horizon-527/pawtrack/README.md

# PawTrack

宠物独立联网定位器 + 微信小程序。目标：项圈设备获取 GNSS 位置，通过 4G 回传，主人在微信中查看位置和运动轨迹。

**当前状态：软件与可编译硬件原型已建立；尚未完成实体板定位、真实微信登录、公网部署及佩戴验收。**

新增 [定制硬件 EVT-A1 交厂包](hardware/custom/evt-a1/README.md)：可编辑原理图、四层布线 PCB、BOM、Gerber/钻孔/贴片坐标、外壳 STL、Air780EGH 应用和36项实体验收表。ERC/DRC/原理图与 PCB 一致性检查通过；制造发布状态 **HOLD**，先由方案商关闭引脚资料矛盾、电源和叠层评审，再做两台样机。该方案由厂商代采、贴片、装配，详见 [交厂说明](hardware/custom/evt-a1/factory-handoff.md)。

## 已实现
- 微信小程序地图、实时刷新、按日期查询轨迹、坐标转换、轨迹缺口分段。
- 微信登录接口、设备绑定、用户设备隔离、在线/定位过期状态、寻找模式请求与设备确认。
- FastAPI + SQLite 服务，独立设备密钥、一次性绑定码、会话过期/撤销、限流、数据删除与30天保留。
- ESP-IDF v5.4.2 固件：SIM7670G AT通信、GNSS读取、HTTPS上传、NVS缓存、模式心跳；ESP32-S3构建通过。
- 设备模拟器、GNSS日志回放、设备初始化、备份恢复工具、Docker/Caddy配置、CI。

## 先体验小程序
微信开发者工具导入 `miniprogram/`。默认使用游客 AppID 和模拟路线，明确标记演示数据。演示无需真实硬件、服务器或微信登录。
正式接入必须替换 AppID 和 HTTPS 服务地址；项目未使用其他项目的 AppID 或密钥。

## 本地运行与验证
```sh
python3 -m venv work/venv
work/venv/bin/pip install -r requirements.lock.txt
work/venv/bin/python tools/check.py
work/venv/bin/uvicorn server.production:create_app --factory --host 127.0.0.1 --port 8788 --no-access-log
```
不配置真实微信密钥时，登录返回“尚未配置”，不会伪造用户身份。接口测试使用隔离的微信响应替身，不代表真实微信认证通过。

## 文档入口
- **[从采购到真实定位：逐步操作指南](docs/getting-started.md)**
- [完整采购和组装](hardware/procurement-and-assembly.md)
- [真机实测与验收表](docs/acceptance.md)
- [常见问题排查](docs/troubleshooting.md)
- [实施与验收计划](docs/plan.md)
- [硬件采购路线](hardware/README.md)
- [固件配置与烧录](firmware/espidf/README.md)
- [服务部署和备份](deploy/README.md)
- [API v1](docs/api-v1.md)
- [测试记录与待办](docs/verification.md)
- [上线门槛](docs/release.md)
- [开源许可](THIRD_PARTY.md)

## 最新完善
支持继续添加另一只宠物，位置5秒轮询/轨迹30秒缓存刷新、手动刷新、历史轨迹终点、会话过期处理；已在微信开发者工具运行并修复坐标库兼容和地图标记渲染问题。
提供独立真机项目配置工具、部署健康/TLS检查、每日自动备份与7天清理、离线恢复、私有TLS负例测试服务。正式微信登录、实体GNSS/4G与佩戴仍须按验收表测试。

## 原始本地原型
`python3 server/app.py`（8787）与 `python3 tools/simulate.py` 为早期本机开发原型；仅监听本机，固定开发令牌，不可公网部署。它的数据库与 v1 独立。
小程序 `config.js` 可切换 apiMode=prototype 且 apiBase 改为8787进行旧版联调；正式流程保持v1。

## 完成产品仍需的外部条件
实体开发板与SIM；小程序AppID/Secret；可部署的服务器/域名；实际定位、TLS证书验证、功耗及佩戴测试。开发板用于桌面验证，不能直接作为宠物项圈成品。
