horizon-527/pawtrack/hardware/README.md

# 硬件路线
当前委托路线改为 [Air780EGH 定制工程样机、由国内厂商代采装配](custom/evt-a1/factory-handoff.md)。CAD、制造输出、外壳和样机验收资料见 [EVT-A1](custom/evt-a1/README.md)。该版尚未投板、实测或获准佩戴。下述微雪开发板内容保留为旧桌面验证路线，不再作为本次采购要求。

[国内采购、到货检查、组装、CA与电池/外壳说明](procurement-and-assembly.md)
推荐桌面原型候选：Waveshare ESP32-S3-SIM7670G-4G，官方介绍包含 GNSS 与 LTE Cat-1。
资料：https://docs.waveshare.net/ESP32-S3-SIM7670G-4G/
国内采购：微雪中文资料所指向的天猫旗舰店 https://weixuesm.tmall.com/ ，或国内商城 https://www.waveshare.net/ 。搜完整型号，套装与版本下单前核对。

这是一块用于开发和验证的板子，不是已可佩戴的成品项圈。购买前必须按当前版本确认：模块频段与国内运营商适配、GNSS 是否实际装配、天线是否包含、供电要求、板尺寸及电池接口。资料充分不代表已实测适配。

采购顺序：
1. 一块上述完整开发板、配套 GNSS 和 4G 天线、匹配的数据 USB 线。
2. 先用厂商支持的稳定 USB 供电，购买一张支持该模块联网的数据 SIM；确认 APN 和套餐是否允许物联网设备。
3. 完成联网和定位后，再依照实际供电接口选带保护电池与充电组件，避免买错极性和规格。
4. 项圈外壳与自制 PCB 留到功耗测试后。

桌面测试记录：日期、板版本、运营商、地点、首次定位耗时、定位点有效比例、上报间隔、延迟、供电和发热。
不要直接把裸板、电池和天线绑到宠物脖子上。最终需要封装、电池保护和牢固固定；猫用方案还需评估脱扣项圈。

## 首轮采购决定
一块官方完整 ESP32-S3-SIM7670G-4G 开发板（优先按V2文档匹配当前在售版本），配套4G/GNSS天线和数据USB线，一张经卖家/运营商确认可用于此模块的数据SIM。总预算暂按1500元上限规划；实际订单价格尚未核验，尚未下单。
先使用稳定USB供电。首轮不买电池、自制PCB或项圈外壳，待真实电流和板尺寸验证后由测量决定。
