horizon-527/pawtrack/docs/acceptance.md

# 真机实测与验收

目的：证明真实设备脱离电脑和手机网络，仍能将真实卫星位置上传，并在自己的微信小程序显示位置/轨迹。自动测试、模拟路线和固件编译不能代替此验收。所有表格初始状态是“待测”。

## 准备和记录

使用自己的 AppID/服务器和专用测试设备，装好天线与 SIM，用稳定 USB 供电。固件实际配置要与服务器同一套设备身份；小程序关闭演示。记录：测试日期、代码提交、PCB 版本、模组固件版本、SIM 运营商/APN、供电方式、测试地点类别、手机/微信版本、执行人。

不在公开仓库上传原始坐标或密钥。私人记录需包括：服务器 receivedAt 与设备 capturedAt、上传间隔、当前模式、在线/定位状态、断网起止、重启次数、缓存点数、电压/电流/Wh。电流与佩戴适配以实体测量为准。

以下数值是**首轮通过标准**，不是已实测指标。每项填写通过/失败、实际数值和证据。失败先排查再重测，不能用“编译成功”代签。

## A. 微信与服务器

| 编号 | 实际操作 | 通过标准 | 结果 |
|---|---|---|---|
| A01 | 从电脑和手机网络检查 HTTPS /health | 证书无异常，健康返回 ok；doctor 检查成功 | 待测 |
| A02 | 真 AppID 手机登录 | 关闭演示后真实登录；未配置凭证不产生身份 | 待测 |
| A03 | 用新 bindingCode 绑定 pet-001 | 名称出现在设备列表；同一码再绑定失败 | 待测 |
| A04 | 等待绑定码 24h 或测试库设置过期 | 过期码拒绝；重发后新 token/绑定码有效 | 待测 |
| A05 | 绑定 pet-002，再切换两只宠物 | 名字、标记、轨迹分别正确，无前一只残留 | 待测 |
| A06 | 第二个微信账号访问 pet-001 | 不出现在列表；接口无法读取或改模式 | 待测 |
| A07 | 退出登录再登录；撤销测试会话 | 旧会话失效，重新登录能访问自己的设备 | 待测 |
| A08 | 测试服务器重启容器/主机 | 设备绑定与轨迹仍在，服务和每日备份恢复 | 待测 |
| A09 | 按运维手册备份并在隔离实例恢复 | 数据库完整，绑定/轨迹一致，不串号 | 待测 |
| A10 | 用专用测试账号执行删除账户 | 在线库轨迹删除、会话与原设备密钥失效；备份到期清理 | 待测 |

删除使用一次性的测试账号/设备；主账号保留。测试完成后恢复正式设备身份材料，不把模拟器和真实板共用同一编号长期运行。

## B. 定位、地图与模式

| 编号 | 实际操作 | 首轮通过标准 | 结果 |
|---|---|---|---|
| B01 | 室外开阔地冷启动，记录首点 | 5 分钟内出现有效坐标/真实 UTC；否则记失败并排查 | 待测 |
| B02 | 静止开阔地 10 分钟，与已知地标对照 | 无数百米系统性坐标偏移；95% 点距参考点 ≤30m 作为初始目标 | 待测 |
| B03 | 人持设备走 300～500m | 路线顺序正确，终点和转弯合理，无人为补点 | 待测 |
| B04 | 普通模式观察 10 分钟 | 采集周期目标 60s；新点端到端年龄95分位 ≤90s | 待测 |
| B05 | 请求寻找模式并持续 10 分钟 | 120s 内显示设备确认；目标周期10s，新点年龄95分位 ≤30s | 待测 |
| B06 | 恢复普通模式 | 设备确认普通，回到目标60s；不只改变页面文字 | 待测 |
| B07 | 比较“后台已经存下”和“小程序显示” | 前台位置约5s轮询；轨迹约30s自动更新，手动刷新即时查询 | 待测 |
| B08 | 查有记录日期、空日期、北京时间跨日 | 点归属日期正确；空日期显示0点；历史终点标记与当天最新位置区分 | 待测 |
| B09 | 模拟至少10分钟断点后再行走 | 不把长时间缺失连接成连续直线 | 待测 |
| B10 | 保持在线，把 GNSS 天线带入无信号环境 | 显示暂无卫星定位，旧点超过120s提示过期；不生成假坐标 | 待测 |
| B11 | 设备关机超过180s | 页面显示离线，旧位置仍标为过期；不能继续声称实时 | 待测 |
| B12 | 快速切宠物、日期、演示，再隐藏/返回小程序 | 旧异步结果不盖住新选择，页面隐藏后停止刷新 | 待测 |
| B13 | 未接/未校准电量计 | 电量显示暂不可用；不显示模拟器的85%为真实电量 | 待测 |

年龄统计只计算首次观察到的不同新点，`观察时刻-capturedAt`；旧点反复刷新不能当作多次新样本。至少记录20个普通点、60个寻找点，再计算排序后95分位。实际延迟超过目标时，检查 AT HTTPS 阻塞与信号；需要时调整通信实现，不能用更快的页面轮询掩盖设备未上传。

## C. 网络、缓存与重启

| 编号 | 实际操作 | 通过标准 | 结果 |
|---|---|---|---|
| C01 | 断开电脑，关闭手机热点，设备用 USB 移动电源运行 | 仍通过 SIM 上传；手机距离改变不影响设备通信 | 待测 |
| C02 | 保持 GNSS/电源，暂时阻断测试服务或置于无蜂窝覆盖环境 | 上传失败后点保留，不能得到成功 ACK 就出队 | 待测 |
| C03 | 缓存未满时断网5分钟，再恢复 | 旧点补传，无重复记录，当前状态最终恢复 | 待测 |
| C04 | 离线缓存形成后重启 ESP，再恢复网络 | 已持久化队列仍可补传；新bootId不与旧序号冲突 | 待测 |
| C05 | 在隔离环境让设备积压超过64点 | 满后保留原64点，拒绝新点并提示；不宣称全部离线点都保存 | 待测 |
| C06 | 在测试服务制造重复ACK/丢失ACK | 重发去重；仅同bootId/sequence的确认能出队 | 待测 |
| C07 | 模组单独掉电再恢复，ESP保持供电 | 重新配置GNSS/TLS并恢复上传；不需要持续人为重启 | 待测 |
| C08 | 无首次GNSS时间冷启动，随后移到室外 | 不绕过证书时间检查；获得时间后正常联网 | 待测 |
| C09 | 换成无效设备token/撤销测试设备密钥 | 服务拒绝；设备保留未确认点，不偷偷降级为HTTP | 待测 |

当前固件64点缓存：理想60s采样约64分钟、10s采样约10分40秒；网络阻塞会影响实际采样。队列满后的新位置不能保留，这是已知限制。首轮先把正常网络和短时断网验收做完。

## D. 模组 TLS 的四组实测

这是硬件上线门槛，使用独立测试 CA 和自己控制的测试域名。**不向外部证书测试网站发送真实 deviceToken，也不关闭证书检查。** 项目提供可重复生成的本地 TLS 测试服务；电脑端正例、错误根、过期和错误域名已经自动测试，但模组端仍待实测。

1. 另准备一个测试域名，例如 `tls.你的域名`，DNS 指向可临时开放8443的测试机。生成证书，目录必须是新目录：

```sh
python3 tools/tls_lab.py generate --directory secrets/tls-lab --hostname tls.你的域名
python3 tools/tls_lab.py serve --directory secrets/tls-lab --mode valid --host 0.0.0.0 --port 8443
```

2. ESP 固件停止，模组用 AT 口操作，GNSS获取正确时间后设置模组 UTC 时钟。用 CA 导入工具把 `secrets/tls-lab/ca.pem` 装为 `pawtrack-lab.pem`。不要覆盖生产 CA。
3. 按手册设置：TLS1.2、authmode=1、ignorelocaltime=0、enableSNI=1、cacert=pawtrack-lab.pem；HTTPINIT，HTTPPARA的SSLCFG=0、URL=`https://tls.你的域名:8443/health`，HTTPACTION=0（GET）。不设置 Authorization。
   对应AT指令如下；域名须替换，模组时间须从实际GNSS UTC设置好：

```text
AT+CSSLCFG="sslversion",0,3
AT+CSSLCFG="authmode",0,1
AT+CSSLCFG="ignorelocaltime",0,0
AT+CSSLCFG="enableSNI",0,1
AT+CSSLCFG="cacert",0,"pawtrack-lab.pem"
AT+HTTPINIT
AT+HTTPPARA="SSLCFG",0
AT+HTTPPARA="URL","https://tls.你的域名:8443/health"
AT+HTTPACTION=0
AT+HTTPTERM
```

4. 完成表中四组。每次切服务先 Ctrl+C 停止，再用相同命令更改 `--mode`；域名、端口、时间和网络保持相同。

| 组别 | 服务证书/模组信任根 | 期望 |
|---|---|---|
| T01 正例 | --mode valid，信任ca.pem | 请求成功，HTTP 200 |
| T02 错误根 | --mode valid，把untrusted-ca.pem导入独立文件并选择它 | TLS失败，不能出现有效HTTP 200 |
| T03 过期 | --mode expired，重新选择正确ca.pem | TLS失败；此时主机名和CA正确 |
| T04 错误域名 | --mode wrong-host，信任正确ca.pem，URL仍是原测试域名 | TLS失败；证书有效但SAN只覆盖wrong.原域名 |

记录模块版本、设置、返回码，不记录真实设备密钥。T04如果竟然成功，说明该模组/配置没有满足本项目主机名验证要求：该硬件不得投入真实使用，通信实现需要迁移到经过验收的 PPP + ESP-TLS。完成后恢复生产 CA 配置与正式固件，关闭测试端口，测试私钥不发布。

## E. 功耗、外壳与佩戴

| 编号 | 实际操作 | 通过标准 | 结果 |
|---|---|---|---|
| E01 | 普通/寻找/弱信号各运行并测峰值 | 不因压降持续重启，电源符合厂家规格 | 待测 |
| E02 | 普通和寻找各记录24h电量Wh | 实测结果能支持所选电池/充电方式；无虚构续航 | 待测 |
| E03 | 先测试电池保护/极性/充电，再取下USB | 供电稳定，正确充电保护；发热异常立即停测 | 待测 |
| E04 | 非金属封装后重复B01/B03/C01 | 外壳不遮挡GNSS/LTE，不造成明显退化 | 待测 |
| E05 | 空壳/等重模型固定与拉扯 | 固定可靠、边缘圆滑、无线材勒颈/勾挂风险 | 待测 |
| E06 | 合适项圈/胸背上由人监督短时佩戴 | 重量尺寸适配，无磨擦、啃咬、过热或不适 | 待测 |
| E07 | 按目标防水方案由供应商验证 | 有真实防水报告才标等级；不能拿裸板淋水验收 | 待测 |

当前未实现精准电量显示、休眠续航优化、可认证防水、量产 PCB 和已适配宠物的外壳。由实体数据决定这些参数；正式可佩戴产品必须完成 E 项，不把桌面软件通过视为可佩戴完成。

## 一次测试的记录模板

```
代码提交 / 日期 / 执行人：
设备PCB / 模组固件 / SIM运营商 / APN：
手机 / 微信版本 / 小程序版本：
用例编号：
操作及环境：
预期：
实际数值：
通过或失败：
私人证据位置（脱敏截图/本地日志/功耗记录）：
修复与重测结果：
```

首次可用门槛：A01～A03、A06、B01～B07、B10～B11、C01～C04和T01～T04通过，才进入持续人持试运行。正式发布还必须通过其余权限/运维用例、[发布门槛](release.md)和相应E项。
