horizon-527/pawtrack/hardware/custom/evt-a1/previews/enclosure-dimensions.png

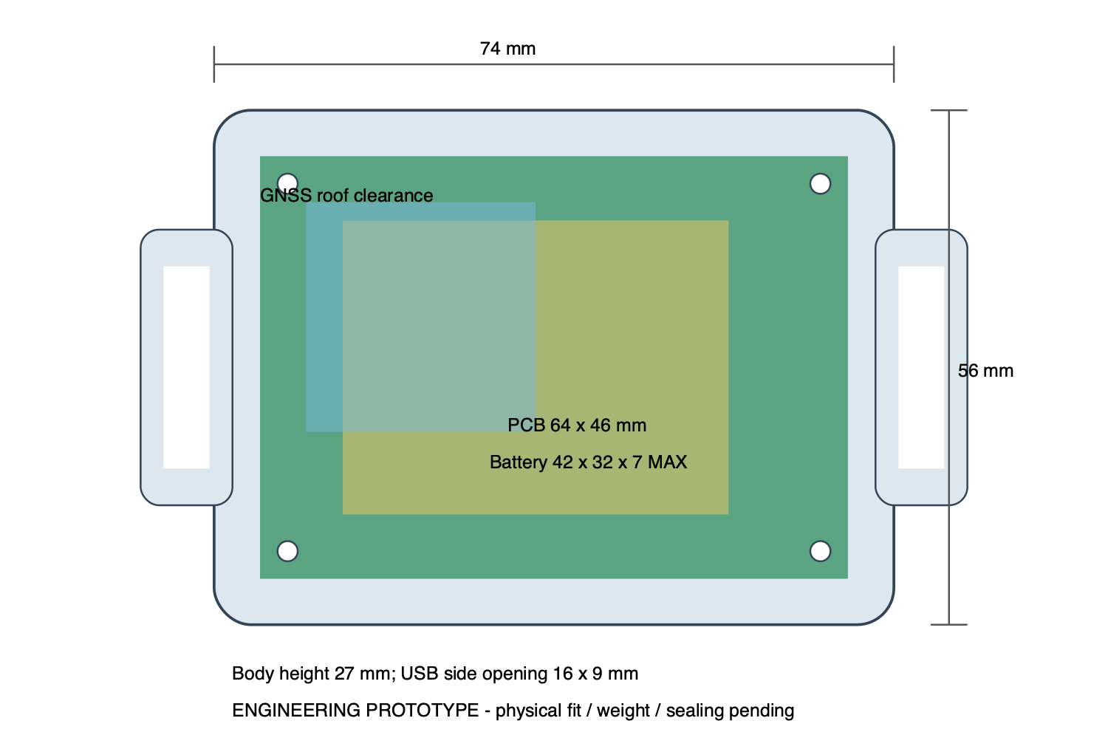
hardware/custom/evt-a1/previews/enclosure-dimensions.png
