horizon-527/pawtrack/hardware/custom/evt-a1/previews/pawtrack.png

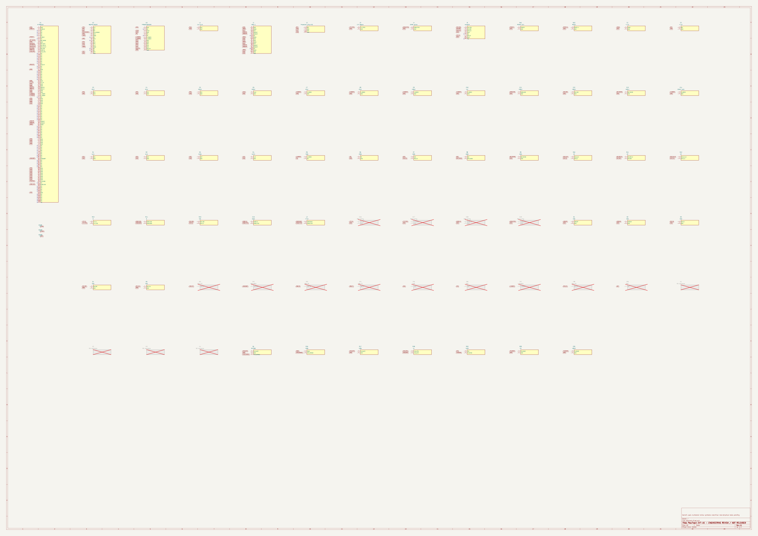
hardware/custom/evt-a1/previews/pawtrack.png
