horizon-527/pawtrack/hardware/custom/evt-a1/previews/pcb-bottom.png

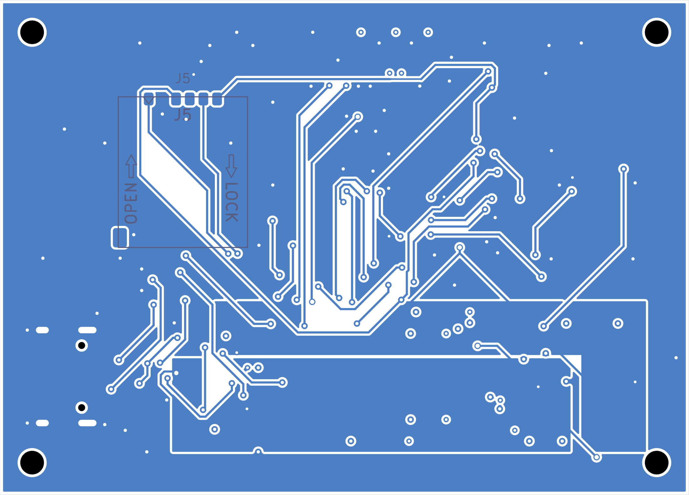
hardware/custom/evt-a1/previews/pcb-bottom.png
