horizon-527/pawtrack/hardware/custom/evt-a1/previews/pcb-top.png

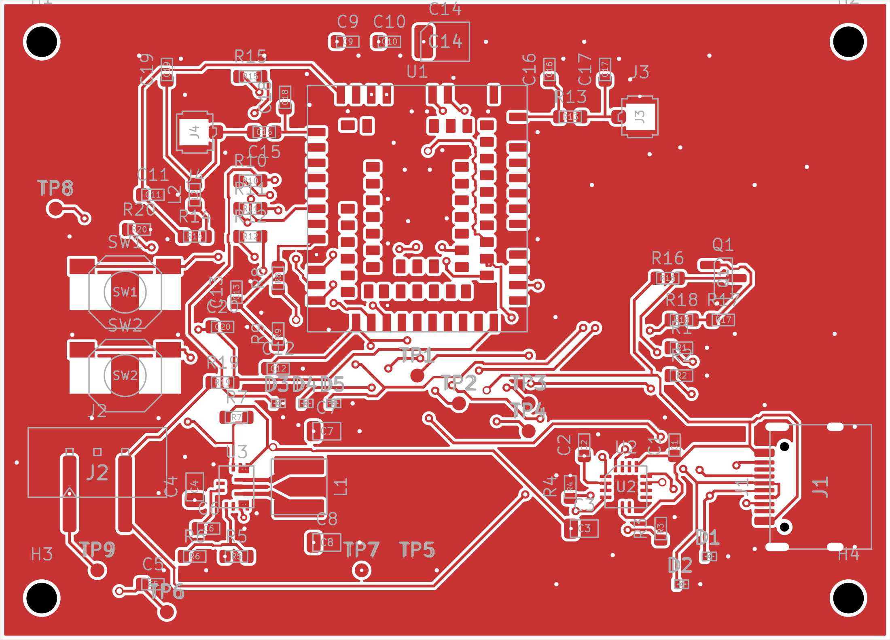
hardware/custom/evt-a1/previews/pcb-top.png
