horizon-527/pawtrack/miniprogram/assets/pet-marker.png

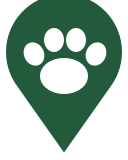
miniprogram/assets/pet-marker.png
