horizon-527/pawtrack/hardware/custom/evt-a1/acceptance.csv

ID | 类别 | 操作 | 验收依据/工程目标 | 状态 | 实际值/证据 | 仪器/环境 | 测试人/日期
REV-01 | 资料 | 合宙确认实际模组 PIN2 与 PIN103 | 最新参考图和硬件手册矛盾得到书面关闭；记录模组批次和依据 | NOT_RUN
REV-02 | 资料 | 方案商独立审核电路/BOM/封装 | 确认109脚方向、RNM15脚、U.FL信号脚、USB/SIM/QFN/NMOS；记录签署版本 | NOT_RUN
FAB-01 | 制板 | 核验叠层、阻抗条、塞孔盖帽和钢网 | 厚1.0mm目标；RF按实际叠层50Ω±10%；VIPPO无开放吸锡孔；提交实际报告 | NOT_RUN
ASM-01 | 贴片 | AOI/X-ray和断电阻值检查 | 无反向、桥连、漏贴；U1/QFN焊接检查；电源无短路；DNP不误贴 | NOT_RUN
PWR-01 | 电源 | 禁用REG_EN后以限流台架电源验证USB/SYS | 不接裸电池；CE默认高禁充；SYS满足BQ规格；没有异常发热 | NOT_RUN
PWR-02 | 电源 | BAT模拟3.3/3.8/4.2V并测MODEM电压 | 目标3.8V；整个测试不超模组3.3–4.3V范围；保存负载及波形 | NOT_RUN
PWR-03 | 电源 | 电子负载模拟0.05A→2A→0.05A阶跃 | 至少100轮、弱网发射同时观察；MODEM不低于3.3V、不复位；记录脉宽和示波器带宽 | NOT_RUN
PWR-04 | 电源 | 4G突发时拔插USB、切换电池供电 | 不复位、不丢已确认队列身份；USB输入受限；电池承担峰值 | NOT_RUN
BAT-01 | 电池 | 核对电池型号、线束和保护资料 | 尺寸≤42×32×7mm、3A放电、独立保护和真实容量；三线极性逐台确认 | NOT_RUN
BAT-02 | 电池 | 用专用测试夹具验证保护阈值 | 按供应商阈值停止过充/过放/过流；提供仪器记录；禁止真实电池硬短路 | NOT_RUN
CHG-01 | 充电 | 未烧程序/复位/未合格配置时接USB | GPIO27 NMOS关，CE高，充电禁止；不是只看指示灯 | NOT_RUN
CHG-02 | 充电 | 合格配置及25°C传感器条件下充电 | 充电电流符合约350mA设计及电池限制；终止电压符合4.2V芯片/电池公差，不超电池规格 | NOT_RUN
CHG-03 | 充电 | 以NTC模拟器+温箱校准0/5/25/40/45°C | NTC真实曲线与ADC温度关键温区误差≤2°C；≤0及≥45°C不充；合格开启范围只能更保守 | NOT_RUN
CHG-04 | 充电 | NTC断路/短路、ADC无效、固件停止/重启 | 禁止充电；核对硬件TS独立切断点；不能由软件假定后备保护通过 | NOT_RUN
CHG-05 | 充电 | 整机充电及正常/弱网/寻找负载热测试 | 记录电芯、IC、外壳最高温和环境；不超器件/电池及经评审接触温度限制 | NOT_RUN
RF-01 | 天线 | 核对GNSS_VDD电压/电流与有源天线规格 | 实测符合天线范围，PIN98不承担其他负载；记录天线型号和安装方向 | NOT_RUN
RF-02 | 天线 | LTE天线装壳前后VNA/OTA及注册测试 | 提供实际频段、安装/人体靠近条件和曲线；按天线/模组厂家指标评估，不把能上网当匹配合格 | NOT_RUN
GNSS-01 | 定位 | 开阔室外冷启动三次并记录时间 | 首轮验收目标每次≤180s获得真实定位；UTC/WGS84字段完整，目标不是实测承诺 | NOT_RUN
GNSS-02 | 定位 | 已知参考点静止10分钟、空旷路段行走 | 首轮目标95%点距参考≤20m；记录原始点、卫星条件和算法；异常点分析 | NOT_RUN
GNSS-03 | 定位 | 室内/遮挡/拔天线后观察状态 | 无有效新点时不伪造坐标；心跳fixValid=false；小程序旧点过期提示正确 | NOT_RUN
NET-01 | 联网 | 激活SIM、APN及运营商频段验证 | 独立4G注册/请求成功；卡号/密钥仅私下保存；记录套餐限制 | NOT_RUN
TLS-01 | 安全 | 实机访问正确CA/有效证书/正确主机名 | 成功；记录exact底层固件版本、证书链和应用哈希 | NOT_RUN
TLS-02 | 安全 | 用错误CA连接测试网关 | 连接拒绝；不上传令牌/位置；不做无CA回退 | NOT_RUN
TLS-03 | 安全 | 有效时间下访问过期证书网关 | 连接拒绝；记录RTC和证书有效期，不以网络超时代替认证拒绝 | NOT_RUN
TLS-04 | 安全 | 正确CA但错误域名证书网关 | 主机名认证拒绝；此测试通过才允许tls_qualified=true | NOT_RUN
APP-01 | 联调 | 真实微信登录、逐台绑定、查看最新点和轨迹 | 与实体设备编号一致；未经归属的用户读不到设备；真实身份联调完成 | NOT_RUN
APP-02 | 联调 | 小程序切finding再normal，跟踪设备心跳 | pending到实际ACK；寻找采样目标10s、普通60s；测采集到展示延迟，工程目标分别≤30s/90s | NOT_RUN
APP-03 | 联调 | 断网10分钟后恢复，检查队列及轨迹 | 已采点按bootId/sequence补传、去重；满64点有丢新计数；不宣称无限缓存 | NOT_RUN
APP-04 | 联调 | 重启设备/中断队列写入/重发延迟ACK | 启动编号不复用；不把错误ACK当成功；记录队列恢复及fskv掉电表现 | NOT_RUN
APP-05 | 联调 | 断电超过180s；跨北京时间自然日查轨迹 | 离线/过期状态及历史日切换正确；WGS84只在地图展示边界转GCJ02 | NOT_RUN
APP-06 | 联调 | 撤销设备密钥/删除账户后尝试上传 | 拒绝旧令牌；设备保留失败队列，使用者看不到已解除数据 | NOT_RUN
LIFE-01 | 续航 | 正常/寻找/弱网分别连续24h采电池侧Wh | 记录平均/峰值、掉线、温度、SIM流量；按实际容量和截止条件计算续航，不使用USB侧直接冒充 | NOT_RUN
MECH-01 | 外壳 | 装配两台，核对电池/SIM/天线/USB/螺丝净空 | 电池不压不刺、不被螺丝顶到；陶瓷不挤；接口可插拔；NTC紧贴电芯 | NOT_RUN
MECH-02 | 外壳 | 称重、等重空壳及人持运动、固定件拉力测试 | 记录实重、尺寸、测试载荷/次数；固定无松脱、锐边、磨损；佩戴对象需单独评估 | NOT_RUN
MECH-03 | 外壳 | 明确防水目标并由方案商修订密封结构测试 | 本版开口无IP声明；有防水需求必须改密封/充电口方案并重新验证 | NOT_RUN
DEL-01 | 交付 | 对照全部文件及测试记录逐台验收 | 每项有实际值/仪器/照片及通过结论；提供最终版本，失败项不得标已完成 | NOT_RUN
