horizon-527/pawtrack/hardware/custom/evt-a1/enclosure/lid-assembly.stl

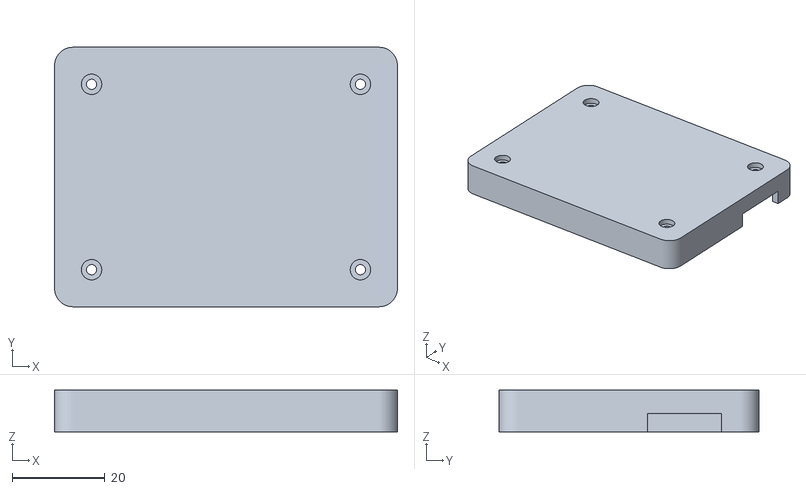
[picture p7: CAD file, 2026-10-11]
hardware/custom/evt-a1/enclosure/lid-assembly.stl
74.0 x 56.0 x 9.00
