horizon-527/pawtrack/hardware/custom/evt-a1/enclosure/base-assembly.stl

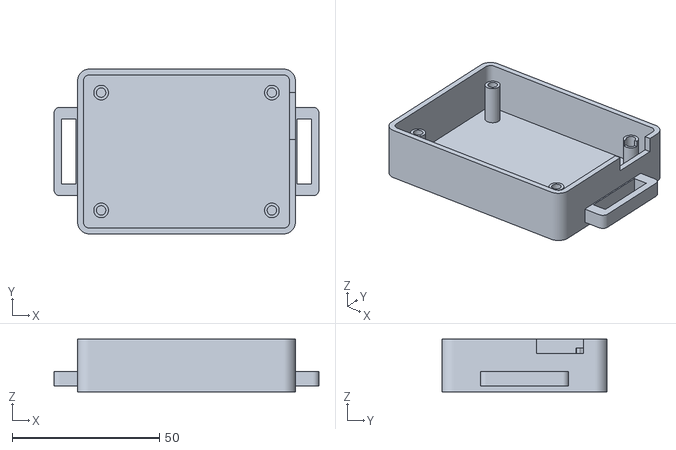
[picture p8: CAD file, 2026-10-11]
hardware/custom/evt-a1/enclosure/base-assembly.stl
90.0 x 56.0 x 18.0
