horizon-527/pawtrack/hardware/custom/evt-a1/enclosure/enclosure.scad

// PawTrack EVT A1. Millimetres. Prototyping only; fit and sealing require samples.
part="assembly";
if(part=="base" || part=="assembly")difference(){union(){difference(){union(){translate([37.0, 28.0, 9]) cube([66, 56, 18],center=true);translate([37.0, 28.0, 9]) cube([74, 48, 18],center=true);translate([4.0, 4.0, 9]) cylinder(r=4,h=18,center=true,$fn=64);translate([4.0, 52.0, 9]) cylinder(r=4,h=18,center=true,$fn=64);translate([70.0, 4.0, 9]) cylinder(r=4,h=18,center=true,$fn=64);translate([70.0, 52.0, 9]) cylinder(r=4,h=18,center=true,$fn=64);}union(){translate([37.0, 28.0, 11]) cube([66, 52, 18],center=true);translate([37.0, 28.0, 11]) cube([70, 48, 18],center=true);translate([4.0, 4.0, 11]) cylinder(r=2,h=18,center=true,$fn=64);translate([4.0, 52.0, 11]) cylinder(r=2,h=18,center=true,$fn=64);translate([70.0, 4.0, 11]) cylinder(r=2,h=18,center=true,$fn=64);translate([70.0, 52.0, 11]) cylinder(r=2,h=18,center=true,$fn=64);}}translate([8, 8, 8.5]) cylinder(r=2.5,h=13,center=true,$fn=64);translate([66, 8, 8.5]) cylinder(r=2.5,h=13,center=true,$fn=64);translate([8, 48, 8.5]) cylinder(r=2.5,h=13,center=true,$fn=64);translate([66, 48, 8.5]) cylinder(r=2.5,h=13,center=true,$fn=64);difference(){union(){translate([-3, 28, 4.5]) cube([6, 30, 5],center=true);translate([-3, 28, 4.5]) cube([10, 26, 5],center=true);translate([-6.0, 15.0, 4.5]) cylinder(r=2,h=5,center=true,$fn=64);translate([-6.0, 41.0, 4.5]) cylinder(r=2,h=5,center=true,$fn=64);translate([0.0, 15.0, 4.5]) cylinder(r=2,h=5,center=true,$fn=64);translate([0.0, 41.0, 4.5]) cylinder(r=2,h=5,center=true,$fn=64);}translate([-3, 28, 4.5]) cube([5, 22, 7],center=true);}difference(){union(){translate([77, 28, 4.5]) cube([6, 30, 5],center=true);translate([77, 28, 4.5]) cube([10, 26, 5],center=true);translate([74.0, 15.0, 4.5]) cylinder(r=2,h=5,center=true,$fn=64);translate([74.0, 41.0, 4.5]) cylinder(r=2,h=5,center=true,$fn=64);translate([80.0, 15.0, 4.5]) cylinder(r=2,h=5,center=true,$fn=64);translate([80.0, 41.0, 4.5]) cylinder(r=2,h=5,center=true,$fn=64);}translate([77, 28, 4.5]) cube([5, 22, 7],center=true);}}translate([72, 40, 17.5]) cube([14, 16, 9],center=true);translate([8, 8, 13]) cylinder(r=1.6,h=6,center=true,$fn=64);translate([66, 8, 13]) cylinder(r=1.6,h=6,center=true,$fn=64);translate([8, 48, 13]) cylinder(r=1.6,h=6,center=true,$fn=64);translate([66, 48, 13]) cylinder(r=1.6,h=6,center=true,$fn=64);}
if(part=="lid")translate([0,0,-18])difference(){difference(){union(){translate([37, 28, 22.5]) cube([66, 56, 9],center=true);translate([37, 28, 22.5]) cube([74, 48, 9],center=true);translate([4.0, 4.0, 22.5]) cylinder(r=4,h=9,center=true,$fn=64);translate([4.0, 52.0, 22.5]) cylinder(r=4,h=9,center=true,$fn=64);translate([70.0, 4.0, 22.5]) cylinder(r=4,h=9,center=true,$fn=64);translate([70.0, 52.0, 22.5]) cylinder(r=4,h=9,center=true,$fn=64);}union(){translate([37, 28, 21.5]) cube([66, 52, 7],center=true);translate([37, 28, 21.5]) cube([70, 48, 7],center=true);translate([4.0, 4.0, 21.5]) cylinder(r=2,h=7,center=true,$fn=64);translate([4.0, 52.0, 21.5]) cylinder(r=2,h=7,center=true,$fn=64);translate([70.0, 4.0, 21.5]) cylinder(r=2,h=7,center=true,$fn=64);translate([70.0, 52.0, 21.5]) cylinder(r=2,h=7,center=true,$fn=64);}translate([72, 40, 17.5]) cube([14, 16, 9],center=true);}translate([8, 8, 22.5]) cylinder(r=1.1,h=12,center=true,$fn=64);translate([66, 8, 22.5]) cylinder(r=1.1,h=12,center=true,$fn=64);translate([8, 48, 22.5]) cylinder(r=1.1,h=12,center=true,$fn=64);translate([66, 48, 22.5]) cylinder(r=1.1,h=12,center=true,$fn=64);translate([8, 8, 26.5]) cylinder(r=2.2,h=2,center=true,$fn=64);translate([66, 8, 26.5]) cylinder(r=2.2,h=2,center=true,$fn=64);translate([8, 48, 26.5]) cylinder(r=2.2,h=2,center=true,$fn=64);translate([66, 48, 26.5]) cylinder(r=2.2,h=2,center=true,$fn=64);}
if(part=="assembly")difference(){difference(){union(){translate([37, 28, 22.5]) cube([66, 56, 9],center=true);translate([37, 28, 22.5]) cube([74, 48, 9],center=true);translate([4.0, 4.0, 22.5]) cylinder(r=4,h=9,center=true,$fn=64);translate([4.0, 52.0, 22.5]) cylinder(r=4,h=9,center=true,$fn=64);translate([70.0, 4.0, 22.5]) cylinder(r=4,h=9,center=true,$fn=64);translate([70.0, 52.0, 22.5]) cylinder(r=4,h=9,center=true,$fn=64);}union(){translate([37, 28, 21.5]) cube([66, 52, 7],center=true);translate([37, 28, 21.5]) cube([70, 48, 7],center=true);translate([4.0, 4.0, 21.5]) cylinder(r=2,h=7,center=true,$fn=64);translate([4.0, 52.0, 21.5]) cylinder(r=2,h=7,center=true,$fn=64);translate([70.0, 4.0, 21.5]) cylinder(r=2,h=7,center=true,$fn=64);translate([70.0, 52.0, 21.5]) cylinder(r=2,h=7,center=true,$fn=64);}translate([72, 40, 17.5]) cube([14, 16, 9],center=true);}translate([8, 8, 22.5]) cylinder(r=1.1,h=12,center=true,$fn=64);translate([66, 8, 22.5]) cylinder(r=1.1,h=12,center=true,$fn=64);translate([8, 48, 22.5]) cylinder(r=1.1,h=12,center=true,$fn=64);translate([66, 48, 22.5]) cylinder(r=1.1,h=12,center=true,$fn=64);translate([8, 8, 26.5]) cylinder(r=2.2,h=2,center=true,$fn=64);translate([66, 8, 26.5]) cylinder(r=2.2,h=2,center=true,$fn=64);translate([8, 48, 26.5]) cylinder(r=2.2,h=2,center=true,$fn=64);translate([66, 48, 26.5]) cylinder(r=2.2,h=2,center=true,$fn=64);}
// Reference PCB and battery (preview only):
%translate([5,5,15])cube([64,46,1]);
%translate([14,12,2])cube([42,32,7]);
