horizon-527/pawtrack/(list of files, cad)

Other CAD files:
hardware/custom/evt-a1/enclosure/lid-print.stl
