horizon-527/pawtrack/hardware/custom/evt-a1/reports/verification.md

# 验证范围与最终结果

本报告对应 EVT-A1 **工程评审包 / HOLD**。原生 KiCad 报告、网表、板清单及制造输出随附。文件 SHA256 在 `files.sha256.json`。报告不得被解释为制造批准或实体通过。

| 检查 | 已执行结果 |
|---|---|
| KiCad10.0.6原生ERC，包含错误/警告/排除项 | 0项违规；默认关闭的4类规则在JSON列明 |
| 原生填铜DRC，包含错误/警告/排除项 | 0违规、0未连接、0原理图与PCB不一致；默认关闭的5类规则在JSON列明 |
| 独立网表→最终PCB→设计清单→BOM→坐标交叉比较 | 71条目一致；54实际贴装器件，顶53/底1；563线段、168过孔 |
| 原生制造输出 | 11个Gerber层、PTH/NPTH钻孔及图、贴片CSV；毫米绝对原点；172 PTH孔/槽、6 NPTH孔 |
| 外壳网格 | 两片均闭合、具有正体积、各1个连通实体；打印坐标与装配坐标分开 |
| Lua5.3协议与队列 | UTC/闰日、无效/过期点、WGS84、ACK身份、模式、64点队列/重启/孤立写入、温度故障禁充和所有Lua语法通过 |
| 实际main.lua→本地真实API | SDK替身下通过绑定、上传、ACK、寻找模式、电量为空、撤销后缓存保留；许可关闭/温度短路/ADC异常禁充 |
| 现有完整软件检查 | 37项Python测试、4组小程序JS测试、C协议及真实本地HTTP小程序流程通过 |
| 原ESP32路线固件 | ESP-IDF5.4.2构建通过；不是定制Air780EGH板的固件 |

**测试替身明确限制**：新程序的GNSS、GPIO、ADC、存储、4G与TLS SDK为替身，测试HTTPS域名被映射到隔离的本机HTTP服务，微信身份由测试替身提供。此测试证明程序与服务器协议联通，不证明真实模组API、射频、证书验证、微信认证或实体存储抗掉电。

**36项实体检查全部 NOT_RUN**。电池保护/温控/充电、公差、供电阶跃、天线、GNSS精度/定位耗时、实际SIM/底层固件、TLS4组、真实微信、24h功耗、装配/重量/拉力/防水及佩戴都没有实测记录。没有设备、仪器和制造订单，无法在电脑上完成这些项目。

制造阻断：合宙PIN2/PIN103矛盾；最终叠层/RF与USB阻抗；电源/热/峰值及固件停止时禁充；电池和天线实物选型；QFN/模块焊接与VIPPO工艺；外壳实物配合。这些由有硬件经验的方案商关闭并更新制造文件后，先做2台。按 `acceptance.csv` 填写仪器/环境/数值及证据，禁止将空表改为无证据PASS。

本版PCB64×46mm，壳体74×56×27mm，含绑带耳90mm长。保留调试余量，整机重量及续航未测，不是已经适用于小猫小狗的量产项圈。没有深度休眠优化、校准SOC或防水等级认证。
