horizon-527/pawtrack/docs/verification.md

# 验证记录（2026-10-11）

## 本机通过
- Python接口、管理、真实HTTP流程与TLS测试：37项通过；包括用户隔离、设备密钥、绑定码、登录失败/过期/退出、消息去重、重启、旧点、分页、删除、限容量重传、一致性备份、清理与恢复、凭证写出失败回滚。
- JavaScript：地图参考坐标、轨迹缺口、演示与设备状态切换、旧请求、v1用户会话、寻找模式确认、北京时间日界线。
- 真实本地HTTP闭环执行实际小程序页面逻辑：隔离微信响应替身 → 绑定两台设备/切换 → 位置上传/坐标 → 缓存刷新 → 模式确认 → 轨迹查询 → 权限隔离 → 删除/旧密钥拒绝，全部通过。
- Docker Compose：使用占位环境值的配置校验通过，没有部署。
- C核心解析：CGPSINFO坐标/时间、无定位、非法坐标/日期、HTTP确认状态；新增完整HTTPREAD帧/声明长度/结束符校验。
- ESP-IDF v5.4.2：目标esp32s3，实际生成pawtrack.bin；默认空凭证构建用于检查，未烧录实体板。
- 微信工具内置WXML/WXSS编译器：两页与样式均通过。原生模拟器实际运行，首页地图/40点路线/宠物标记、关闭演示后的登录入口已确认，修复后Errors=0。隐私页导航已触发，后续Mac锁屏使最后视觉复查未完成；路由/编译通过。游客模式不代表真实微信认证。
- 坐标库增加module但无exports绑定环境的回归检查；会话过期和迟到401保留新登录测试通过。
- 私有TLS测试服务：电脑实际TLS正例、错误根/过期/错误SAN三种分别拒绝且错误类型匹配。模组端尚未测试。
- 自动备份文件0600/目录700、在线库0600、7天清理、完整性校验、坏备份拒绝及离线恢复通过；备份转换为DELETE模式，在只读目录/容器备份卷恢复通过。
- 从干净导出的源码副本重新运行37项Python测试、4套JavaScript检查和C核心检查通过；测试脚本兼容不含.git的源码包。

## 仍待外部验收
真实微信登录与手机预览、真实GNSS与运营商4G、证书主机名验证、断网与重启功耗、项圈佩戴。
Docker CLI已安装，但本机无运行中的Docker服务；工作目录内Compose工具配置校验通过。本轮GitHub CI已构建部署镜像，完成健康/未配置微信拒绝登录、非root容器命名卷备份、只读备份卷恢复和Caddy配置验证。真实域名证书与运行环境仍需部署机验收。
项目未使用任何其他项目账号，也未部署到公网。

## 重跑
`work/venv/bin/python tools/check.py`
固件：ESP-IDF环境中 `idf.py -C firmware/espidf build`。
CI包含软件测试、ESP-IDF构建、部署镜像/备份恢复/网关配置；远程结果以仓库Actions页面为准，本机通过不代表远程通过。

## 远程验证结果
运行代码提交 `0af5625bb8f1107e5ad72d5386d72081fe3afeb0` 的软件测试、ESP32-S3固件构建和部署容器检查全部成功：
[GitHub Actions完整结果](https://github.com/horizon-527/pawtrack/actions/runs/38113926025)。
生产镜像SQLite为3.53.0，编译前验证官方sqlite3.c的SHA3；CI实际验证其版本、非root服务启动、在线备份与只读恢复。Compose与Caddy配置检查成功。运行代码未改动；后续交付、采购与验证文档更新不改变上述测试对应的代码。

精准电量、休眠续航、量产PCB/外壳、防水与宠物佩戴未完成，不能称为商业项圈已交付。实际步骤和通过标准见[43项验收表](acceptance.md)。
