horizon-527/pawtrack/(list of files, drawings)

Other design files:
hardware/custom/evt-a1/cad/pawtrack.dsn
