horizon-527/pawtrack/hardware/custom/evt-a1/cad/pawtrack.kicad_pcb

## KiCad design hardware/custom/evt-a1/cad/pawtrack.kicad_pcb (2026-10-11)

Schematic: pawtrack.kicad_sch, PawTrack EVT-A1 - ENGINEERING REVIEW / NOT RELEASED

Parts:
C1, C2: 4.7uF; C_0603_1608Metric; MPN GRM188R61A475KE15D
C3, C4, C7, C8: 22uF; C_0805_2012Metric; MPN GRM21BR60J226ME39L
C5, C6, C9, C11, C12, C13, C20: 100nF; C_0603_1608Metric; MPN GRM188R71C104KA01D
C10: 1uF; C_0603_1608Metric; MPN GRM188R61A105KA61D
C14: 100uF 6.3V; CP_EIA-3528-21_Kemet-B; MPN T520B107M006ATE070
C15: 33pF; C_0603_1608Metric; MPN GRM1885C1H330JA01D
C16, C17, C18, C19: DNP tuning; C_0603_1608Metric; MPN DNP tuning; not fitted
D1, D2: ESD; D_SOD-882; MPN PESD5V0S1UL,315
D3, D4, D5: ESD; D_SOD-882; MPN PESD3V3S1UL,315
H1, H2, H3, H4: M2 clearance; MountingHole_2.2mm_M2; MPN PCB feature; not fitted
J1: USB-C; USB_C_Receptacle_HRO_TYPE-C-31-M-12; MPN TYPE-C-31-M-12
J2: Protected LiPo+NTC; JST_PH_B3B-PH-SM4-TB_1x03-1MP_P2.00mm_Vertical; MPN B3B-PH-SM4-TB(LF)(SN)
J3: LTE 50ohm; U.FL_Hirose_U.FL-R-SMT-1_Vertical; MPN U.FL-R-SMT-1(10)
J4: GNSS active; U.FL_Hirose_U.FL-R-SMT-1_Vertical; MPN U.FL-R-SMT-1(10)
J5: nanoSIM; nanoSIM_Hinged_CUI_NSIM-2-C; MPN NSIM-2-C
L1: 1uH 5.4A; XFL4020; MPN XFL4020-102MEC
L2: 47nH; L_0603_1608Metric; MPN 0603HP-47NXJRW
Q1: 2N7002; SOT-23; MPN 2N7002,215
R1, R2: 5.1k; R_0603_1608Metric; MPN RC0603FR-075K1L
R3: 2.55k; R_0603_1608Metric; MPN RC0603FR-072K55L
R4: 3.24k; R_0603_1608Metric; MPN RC0603FR-073K24L
R5: 750k; R_0603_1608Metric; MPN RC0603FR-07750KL
R6: 200k; R_0603_1608Metric; MPN RC0603FR-07200KL
R7, R9, R16, R17: 100k; R_0603_1608Metric; MPN RC0603FR-07100KL
R8: 330k; R_0603_1608Metric; MPN RC0603FR-07330KL
R10, R11, R12: 22; R_0603_1608Metric; MPN RC0603FR-0722RL
R13, R14: 0; R_0603_1608Metric; MPN RC0603JR-070RL
R15: 10k; R_0603_1608Metric; MPN RC0603FR-0710KL
R18: 1k; R_0603_1608Metric; MPN RC0603FR-071KL
R19: 3.3M; R_0603_1608Metric; MPN RC0603FR-073M3L
R20: 1M; R_0603_1608Metric; MPN RC0603FR-071ML
SW1: POWER KEY; SW_SPST_SKQG_WithoutStem; MPN SKQGAKE010
SW2: RESET; SW_SPST_SKQG_WithoutStem; MPN SKQGAKE010
TP1: VDD_EXT; TestPoint_Pad_D1.0mm; MPN PCB pad; not fitted
TP2: USB_BOOT; TestPoint_Pad_D1.0mm; MPN PCB pad; not fitted
TP3: DBG_RX; TestPoint_Pad_D1.0mm; MPN PCB pad; not fitted
TP4: DBG_TX; TestPoint_Pad_D1.0mm; MPN PCB pad; not fitted
TP5: GND; TestPoint_Pad_D1.0mm; MPN PCB pad; not fitted
TP6: SYS; TestPoint_Pad_D1.0mm; MPN PCB pad; not fitted
TP7: V_MODEM; TestPoint_Pad_D1.0mm; MPN PCB pad; not fitted
TP8: REG_EN; TestPoint_Pad_D1.0mm; MPN PCB pad; not fitted
TP9: BAT; TestPoint_Pad_D1.0mm; MPN PCB pad; not fitted
U1: Air780EGH; Air780EGH_109; MPN Air780EGH
U2: BQ24074RGTR; WQFN-16-1EP_3x3mm_P0.5mm_EP1.68x1.68mm; MPN BQ24074RGTR
U3: TPS63070RNMR; TPS63070_RNM0015A; MPN TPS63070RNMR

Connections:
BAT: C2.1 (BAT), J2.1 (BAT), R8.1 (BAT), TP9.1, U2.2 (BAT), U2.3 (BAT)
BAT_SENSE: C13.1 (BAT_SENSE), R8.2 (BAT_SENSE), R9.1 (BAT_SENSE), U1.9 (BAT_SENSE)
CC1: J1.A5 (CC1), R1.1 (CC1)
CC2: J1.B5 (CC2), R2.1 (CC2)
CHG_CTRL: R18.1 (CHG_CTRL), U1.16 (CHG_CTRL)
CHG_DISABLE: Q1.3 (CHG_DISABLE), R16.2 (CHG_DISABLE), U2.4 (CHG_DISABLE)
CHG_GATE: Q1.1 (CHG_GATE), R17.1 (CHG_GATE), R18.2 (CHG_GATE)
DBG_RX: TP3.1, U1.38 (DBG_RX)
DBG_TX: TP4.1, U1.39 (DBG_TX)
FB: R5.2 (FB), R6.1 (FB), U3.5 (FB)
GND: C1.2 (GND), C2.2 (GND), C3.2 (GND), C4.2 (GND), C5.2 (GND), C6.2 (GND), C7.2 (GND), C8.2 (GND), C9.2 (GND), C10.2 (GND), C11.2 (GND), C12.2 (GND), C13.2 (GND), C14.2 (GND), C16.2 (GND), C17.2 (GND), C18.2 (GND), C19.2 (GND), C20.2 (GND), D1.2 (GND), D2.2 (GND), D3.2 (GND), D4.2 (GND), D5.2 (GND), J1.A1 (GND), J1.A12 (GND), J1.B1 (GND), J1.B12 (GND), J1.SH (GND), J2.2 (GND), J2.MP (GND), J3.2 (GND), J4.2 (GND), J5.5 (GND), J5.SH (GND), Q1.2 (GND), R1.2 (GND), R2.2 (GND), R3.2 (GND), R4.2 (GND), R6.2 (GND), R9.2 (GND), R17.2 (GND), R20.2 (GND), SW1.2 (GND), SW2.2 (GND), TP5.1, U1.1 (GND), U1.10 (GND), U1.27 (GND), U1.34 (GND), U1.36 (GND), U1.37 (GND), U1.40 (GND), U1.41 (GND), U1.45 (GND), U1.46 (GND), U1.47 (GND), U1.48 (GND), U1.70 (GND), U1.71 (GND), U1.72 (GND), U1.73 (GND), U1.88 (GND), U1.89 (GND), U1.90 (GND), U1.91 (GND), U1.92 (GND), U1.93 (GND), U1.94 (GND), U1.95 (GND), U1.103 (GND), U2.5 (GND), U2.8 (GND), U2.17 (GND), U3.1 (GND), U3.4 (GND), U3.10 (GND), U3.15 (GND)
GNSS_BIAS: L2.1 (GNSS_BIAS), R14.2 (GNSS_BIAS)
GNSS_FEED: C15.2 (GNSS_FEED), C19.1 (GNSS_FEED), J4.1 (GNSS_FEED), L2.2 (GNSS_FEED)
GNSS_IN: C15.1 (GNSS_IN), C18.1 (GNSS_IN), U1.2 (GNSS_IN)
GNSS_VDD: C11.1 (GNSS_VDD), R14.1 (GNSS_VDD), U1.98 (GNSS_VDD)
ILIM: R4.1 (ILIM), U2.12 (ILIM)
ISET: R3.1 (ISET), U2.16 (ISET)
LTE_FEED: C17.1 (LTE_FEED), J3.1 (LTE_FEED), R13.2 (LTE_FEED)
LTE_IN: C16.1 (LTE_IN), R13.1 (LTE_IN), U1.35 (LTE_IN)
NTC: J2.3 (NTC), R19.1 (NTC), U2.1 (NTC)
PWRKEY: SW1.1 (PWRKEY), U1.7 (PWRKEY)
REG_EN: R7.2 (REG_EN), TP8.1, U3.14 (REG_EN)
RESET_N: SW2.1 (RESET_N), U1.15 (RESET_N)
SIM_CLK: D5.1 (SIM_CLK), J5.3 (SIM_CLK), R12.2 (SIM_CLK)
SIM_CLK_M: R12.1 (SIM_CLK_M), U1.13 (SIM_CLK_M)
SIM_IO: D3.1 (SIM_IO), J5.7 (SIM_IO), R10.2 (SIM_IO), R15.2 (SIM_IO)
SIM_IO_M: R10.1 (SIM_IO_M), U1.11 (SIM_IO_M)
SIM_RST: D4.1 (SIM_RST), J5.2 (SIM_RST), R11.2 (SIM_RST)
SIM_RST_M: R11.1 (SIM_RST_M), U1.12 (SIM_RST_M)
SIM_VDD: C12.1 (SIM_VDD), J5.1 (SIM_VDD), R15.1 (SIM_VDD), U1.14 (SIM_VDD)
SW1: L1.1 (SW1), U3.11 (SW1)
SW2: L1.2 (SW2), U3.9 (SW2)
SYS: C3.1 (SYS), C4.1 (SYS), C5.1 (SYS), R7.1 (SYS), TP6.1, U2.10 (SYS), U2.11 (SYS), U3.12 (SYS), U3.13 (SYS)
TS_SENSE: C20.1 (TS_SENSE), R19.2 (TS_SENSE), R20.1 (TS_SENSE), U1.96 (TS_SENSE)
USB_BOOT: TP2.1, U1.82 (USB_BOOT)
USB_DM: D2.1 (USB_DM), J1.A7 (USB_DM), J1.B7 (USB_DM), U1.60 (USB_DM)
USB_DP: D1.1 (USB_DP), J1.A6 (USB_DP), J1.B6 (USB_DP), U1.59 (USB_DP)
VAUX: C6.1 (VAUX), U3.3 (VAUX)
VBUS: C1.1 (VBUS), J1.A4 (VBUS), J1.A9 (VBUS), J1.B4 (VBUS), J1.B9 (VBUS), R16.1 (VBUS), U1.61 (VBUS), U2.6 (VBUS), U2.13 (VBUS)
VDD_EXT: TP1.1, U1.24 (VDD_EXT)
V_MODEM: C7.1 (V_MODEM), C8.1 (V_MODEM), C9.1 (V_MODEM), C10.1 (V_MODEM), C14.1 (V_MODEM), R5.1 (V_MODEM), TP7.1, U1.42 (V_MODEM), U1.43 (V_MODEM), U3.7 (V_MODEM), U3.8 (V_MODEM)

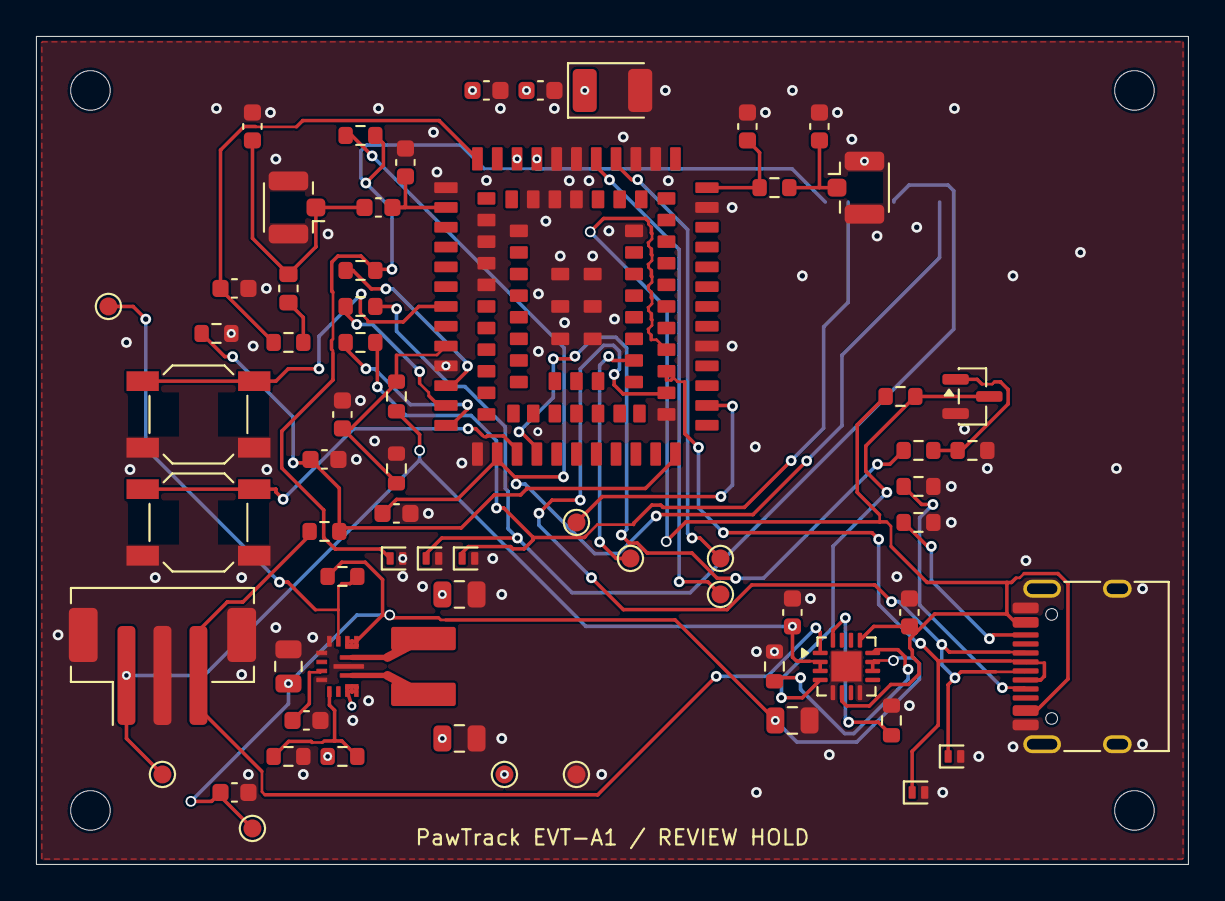
[picture p9: board pawtrack.kicad_pcb from above]

Board: 4 copper layers, 64.0 x 46.0 mm, 71 parts (1 on the bottom side), 41 nets.
