horizon-527/pawtrack/(commit log)

2026-10-11 Build PawTrack local tracking prototype and device integration tools
2026-10-11 Add authenticated WeChat app, deployment tooling and ESP32 tracker firmware
2026-10-11 Complete real-device setup, software flows and operational verification
2026-10-11 Fix standalone backup restore and pin patched SQLite runtime
    [backup.py]
2026-10-11 Add custom Air780EGH EVT hardware, manufacturing exports and factory acceptance package
    [acceptance.csv, base-assembly.stl, base-print.stl, bom.csv, enclosure.scad, lid-assembly.stl, lid-print.stl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]
2026-10-11 Clarify prototype fastener engagement in factory handoff [skip ci]
